sparkfun/Wireless_Kill_Switch/readme.md

Wireless Kill Switch
======================

Wireless turn on/off large relays that allow a remote user to deactivate or shut down a thing that may be potentially dangerous (a big power source, motor, etc.).

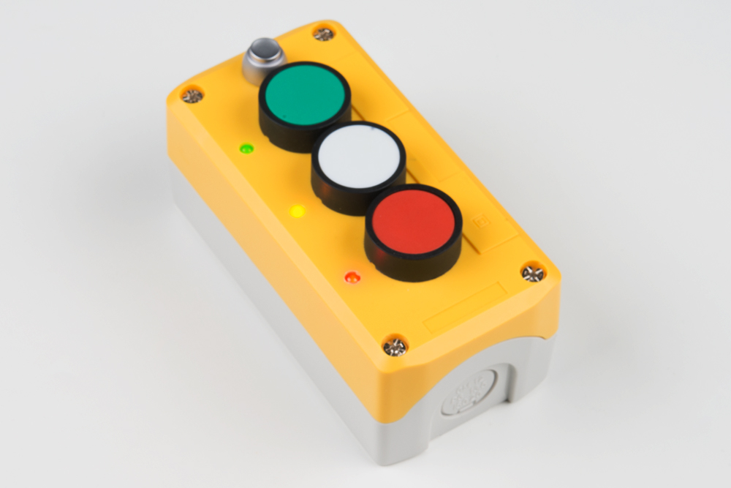
[picture p1: Documentation/Kill_Switch_Images-01.jpg]
Kill switch remote control


_*A kill switch remote control*_

Repository Contents
-------------------
* **/Documentation** - Images of the Kill Switch
* **/Firmware** - Example code 
* **/Wiring_Diagrams** - Eagle design files (.sch) and .PDFS

Documentation
-------------
* **[How to build a wireless kill switch](https://learn.sparkfun.com/tutorials/how-to-build-a-remote-kill-switch)** - Tutorial with more information, including a parts list. 
* **[Video demonstration of the kill switch](https://www.youtube.com/watch?v=idKhC2QLU6c)** - We blend some margaritas and demo the wireless control
* **[SparkFun Fritzing repo](https://github.com/sparkfun/Fritzing_Parts)** - Fritzing diagrams for SparkFun products.
* **[SparkFun 3D Model repo](https://github.com/sparkfun/3D_Models)** - 3D models of SparkFun products. 

License Information
-------------------

This code is _**open source**_! 

Please review the LICENSE.md file for license information. 

If you have any questions or concerns on licensing, please contact techsupport@sparkfun.com.

Distributed as-is; no warranty is given.

- Your friends at SparkFun.
