sparkfun/Wireless_Kill_Switch/Documentation/Kill_Switch-Remote-Control-Unit.jpg

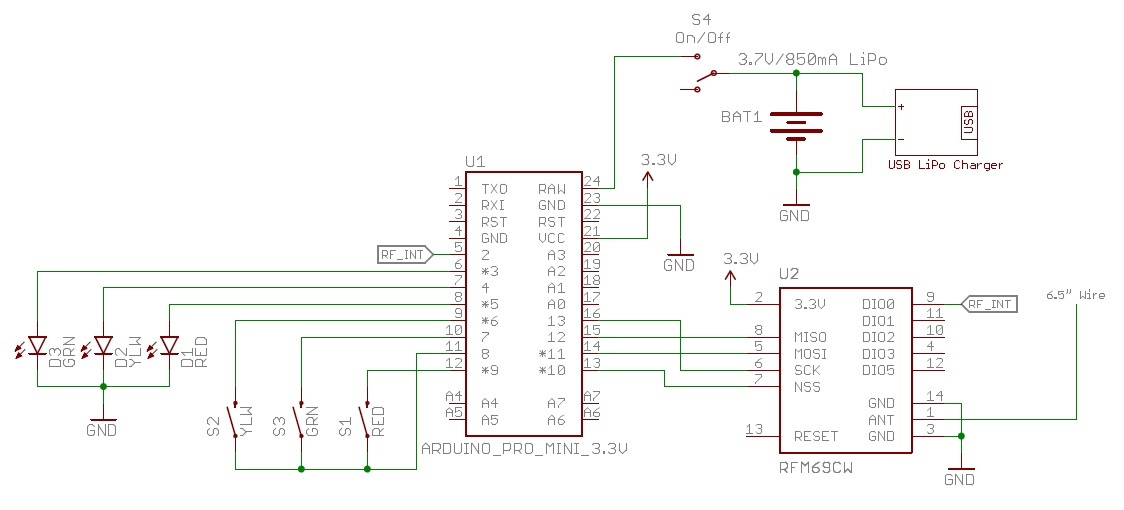
Documentation/Kill_Switch-Remote-Control-Unit.jpg
