sparkfun/Wireless_Kill_Switch/Documentation/Kill_Switch_Images-02.jpg

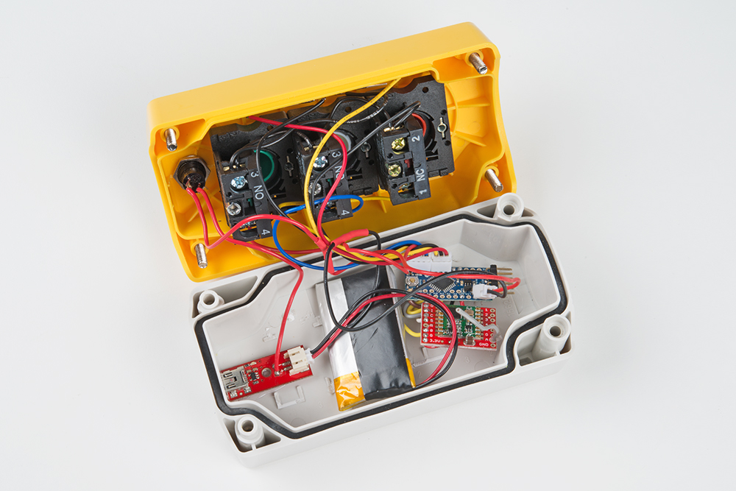
Documentation/Kill_Switch_Images-02.jpg
