sparkfun/Wireless_Kill_Switch/Wiring_Diagrams/Remote_Control_Wiring.pdf

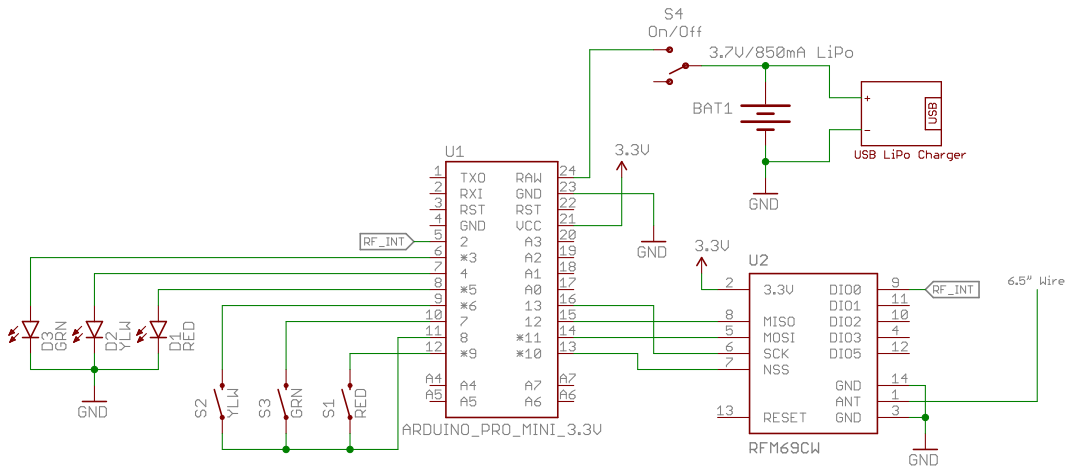
[picture p4: page 1]
