sparkfun/Wireless_Kill_Switch/Wiring_Diagrams/Vehicle_Kill_Switch_Wiring.pdf

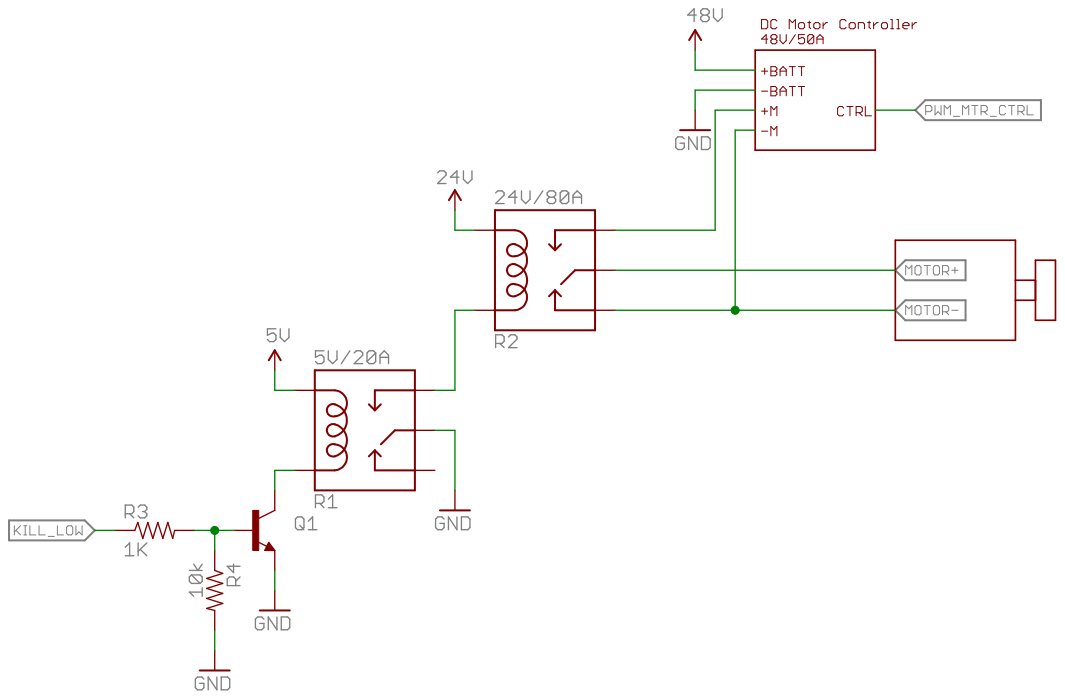
[picture p5: page 1]
