sparkfun/Wireless_Kill_Switch/Wiring_Diagrams/Remote_Control_Wiring.sch

## EAGLE design Wiring_Diagrams/Remote_Control_Wiring.sch (2016-05-24)

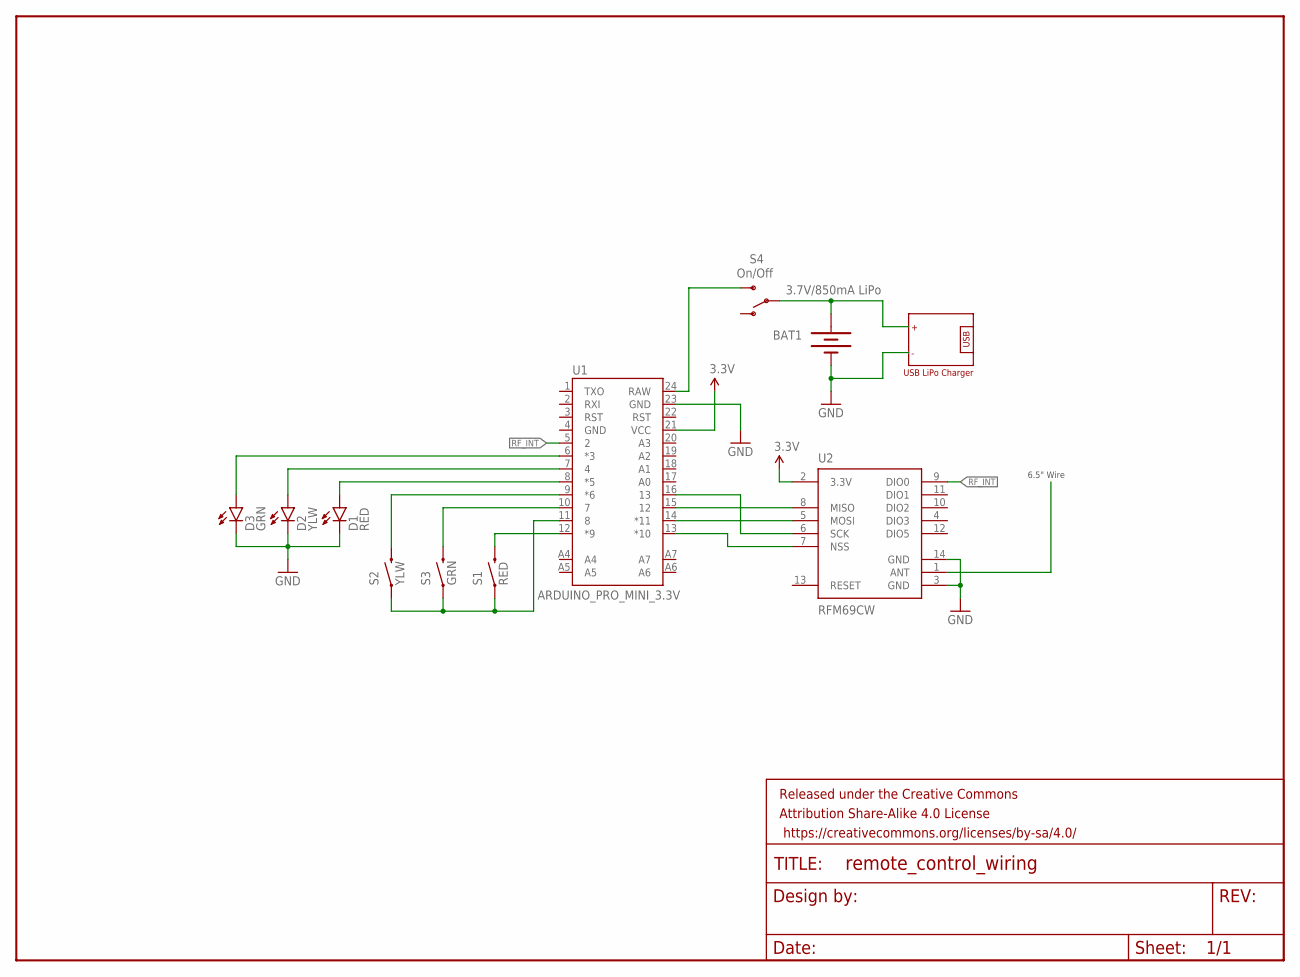
[picture p6: schematic Remote_Control_Wiring.sch]

Parts:
BAT1: 3.7V/850mA LiPo; LIPO-110-TABS
D1: RED; LED5MM
D2: YLW; LED5MM
D3: GRN; LED5MM
FRAME1: FRAME-LETTER; CREATIVE_COMMONS
S1: RED; TACTILE-PTH
S2: YLW; TACTILE-PTH
S3: GRN; TACTILE-PTH
S4: On/Off; SWITCH-SPDT
U1: ARDUINO_PRO_MINI_3.3V; ARDUINO_PRO_MINI
U2: RFM69CW; RFM69CW-XXXS2

Connections:
3.3V: U1.21 (VCC), U2.2 (3.3V)
GND: BAT1.-, D1.K (C), D2.K (C), D3.K (C), U1.23 (GND), U2.3 (GND), U2.14 (GND)
unnamed: S1.3 (2), U1.12 (*9)
unnamed: S3.3 (2), U1.10 (7)
unnamed: S2.3 (2), U1.9 (*6)
unnamed: D1.A, U1.8 (*5)
unnamed: D2.A, U1.7 (4)
unnamed: D3.A, U1.6 (*3)
unnamed: S1.1, S2.1, S3.1, U1.11 (8)
unnamed: U1.15 (12), U2.8 (MISO)
unnamed: U1.14 (*11), U2.5 (MOSI)
unnamed: U1.16 (13), U2.6 (SCK)
unnamed: U1.13 (*10), U2.7 (NSS)
unnamed: S4.3 (S), U1.24 (RAW)
unnamed: BAT1.+, S4.2
RF_INT: U1.5 (2), U2.9 (DIO0)

Notes on the sheet:
6.5" Wire
USB LiPo Charger
USB
