sparkfun/Wireless_Kill_Switch/Wiring_Diagrams/Vehicle_Kill_Switch_Wiring.sch

## EAGLE design Wiring_Diagrams/Vehicle_Kill_Switch_Wiring.sch (2016-05-24)

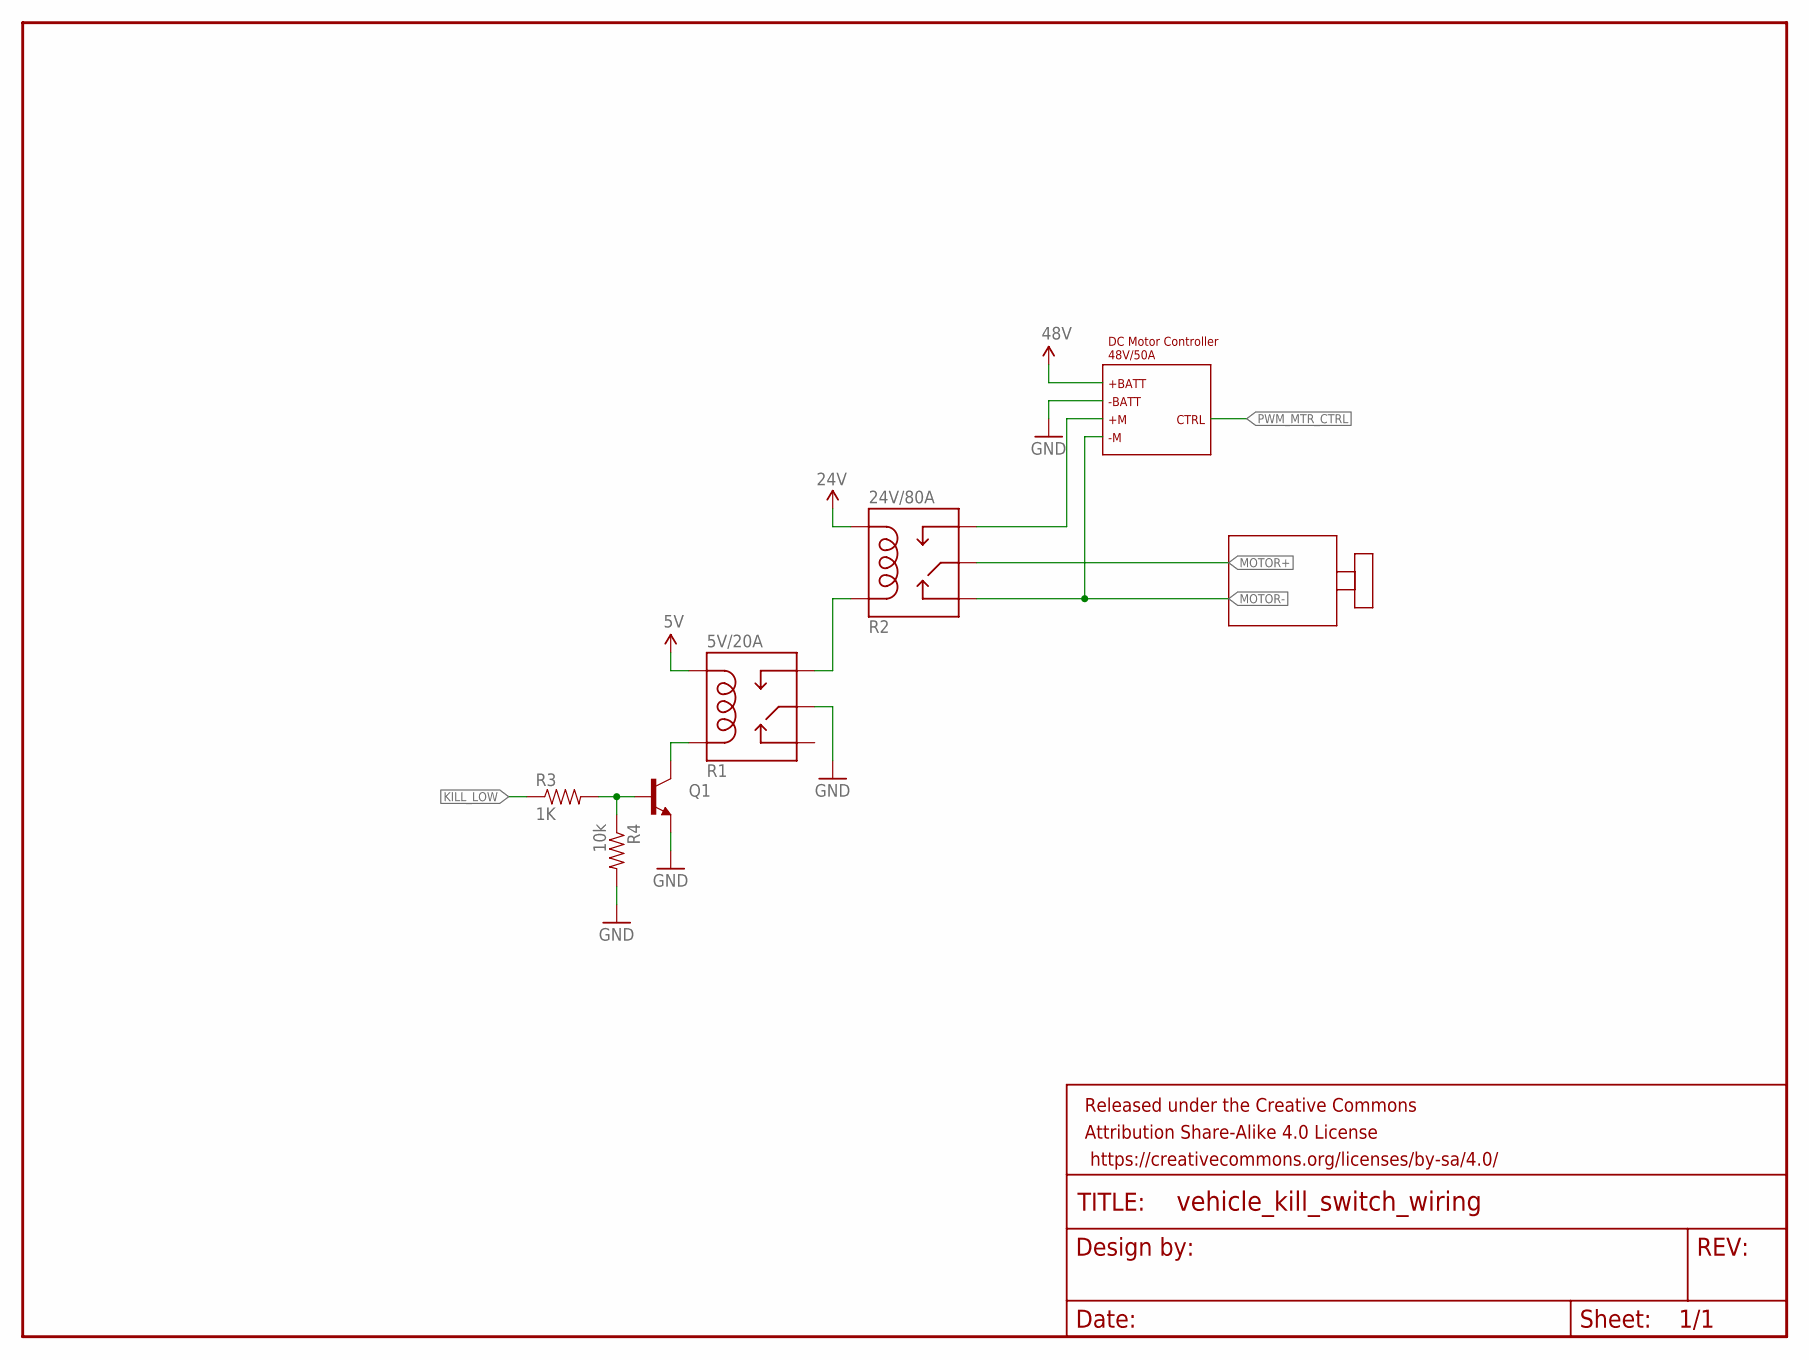
[picture p7: schematic Vehicle_Kill_Switch_Wiring.sch]

Parts:
FRAME1: FRAME-LETTER; CREATIVE_COMMONS
Q1: TRANSISTOR_NPN2N3904; TO-92
R1: 5V/20A; RELAY-G5Q
R2: 24V/80A; RELAY-G5Q
R3: 1K; AXIAL-0.3
R4: 10k; AXIAL-0.3

Connections:
48VFROM_CONTROLLER: R2.3 (NO)
GND: Q1.1 (E), R1.2 (MAIN), R4.P$2 (2)
KILL_LOW: R3.P$1 (1)
MOTOR+: R2.2 (MAIN)
MOTOR-: R2.4 (NC)
unnamed: R1.3 (NO), R2.5 (COIL1)
unnamed: Q1.3 (C), R1.5 (COIL1)
unnamed: Q1.2 (B), R3.P$2 (2), R4.P$1 (1)
VCC_1: R2.1 (COIL2)
VCC_2: R1.1 (COIL2)

Notes on the sheet:
DC Motor Controller 48V/50A
-BATT
+BATT
CTRL
