sparkfun/Wireless_Kill_Switch/Documentation/Kill_Switch-Relay-Setup.jpg

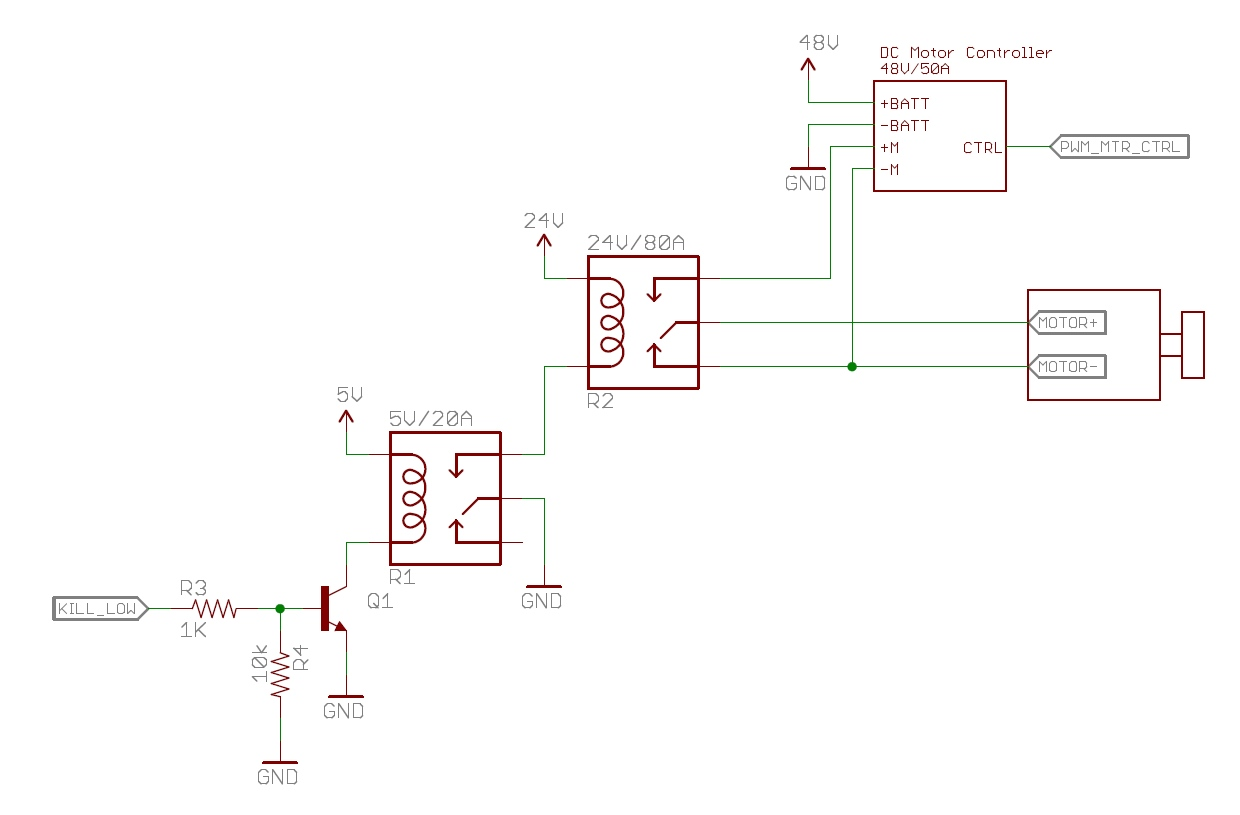
Documentation/Kill_Switch-Relay-Setup.jpg
