sparkfun/Wireless_Kill_Switch/(commit log)

2016-05-24 Initial commit
    Adding the initial files
    [Remote Control Wiring.sch, Vehicle Kill-Switch Wiring.sch]
2016-05-25 Cleaning up file names, directory structure
    [Remote_Control_Wiring.sch, Vehicle_Kill_Switch_Wiring.sch]
